tsaitepiao-alt/collar-frame/downloads/assembly.md

# 嘉蘭一號／二號 頸圈框：組裝與打樣

## 這是什麼

把「模組 + 織帶」串起來的**頸圈框**，機構分工寫死：

| 受力方向 | 誰負責 | 做法 |
|---|---|---|
| 側向／旋轉 | **機械擋（框壁）** | 6 mm 框壁把模組四面夾住，單邊 0.35 mm 餘隙 |
| 往下 | **機械擋（底部托台）** | 腔底留 2 mm 高托台，模組坐上去，重力也幫它 |
| 往外脫 | **磁吸（N35 Ø6×2 ×2）** | 只負責貼合與手感，不承力 |
| 前後 | **磁吸（扣件）** | 公母片對吸 |
| 拉力／剪力（扣件） | **機械擋（掛勾 + 擋牆）** | 勾子跨過母片上緣卡住，磁鐵不承力 |

**為什麼這樣分**：磁鐵一旦承力，貓甩頭幾次就會位移；反過來全部靠卡扣，單手又扣不上。所以磁鐵管「對位與手感」，擋塊管「受力」。

## 檔案

| 檔案 | 內容 |
|---|---|
| `src/lib/collar_params.py` | 全部尺寸的唯一來源（模組、磁鐵、織帶、扣件） |
| `src/lib/collar_shapes.py` | 框體／模組參考件／扣件幾何 |
| `src/frame_a.py` → `STEP/frame_a.step` | 嘉蘭一號框（68.5 × 44.5 × 11.5，零突出） |
| `src/frame_b.py` → `STEP/frame_b.step` | 嘉蘭二號框（56 × 44 × 17.8 模組） |
| `src/clasp_male.py` / `clasp_female.py` | 織帶扣件公／母 |
| `tmp/check_parts.py` | 幾何驗證（布林量體） |
| `PNG/` | 出圖 |

## 尺寸（來源）

- 嘉蘭一號 63 × 39 × 15、R7（`collar-base-system.html` VD.a）
- 嘉蘭二號 56 × 44 × 17.8、R7（VD.b）
- 織帶 20 × 2.5 mm（同頁零件表）
- 框外：一號 68.5 × 44.5、二號 61.5 × 49.5（= 模組 + 2×0.35 間隙 + 2×2.4 壁）

## 組裝順序

1. **埋磁鐵**（列印後）：把 Ø6×2 N35 放進背面的兩個窩（窩深 2.6，磁鐵 2.0 → 剩 0.6 給蓋片）。
2. **封蓋片**：Ø6.15 × 0.6 的蓋片壓入，**超音波熔接或溶劑黏（永久）**。這一步是防貓誤食的關鍵，不可只用雙面膠。
3. **裝模組**：模組上緣先斜入，下緣落到**底部托台**上，上緣兩角被磁鐵吸住。
4. **穿織帶**：20 mm 織帶從**背板內的貫穿通道**（21 × 2.8）穿過去，左右各留需要的長度後回折縫死／上調節扣。**先穿織帶再裝模組**，順序反了會卡住。
5. **接扣**：公片掛勾跨過母片上緣 → 勾子落進凹槽、碰到底部擋牆；兩片磁鐵對吸。
6. **拆**：掀上緣（磁力即可克服），或單手把扣件往反方向推開。

## 打樣

- **SLS PA12**（首選）：韌性好，卡扣與框耳不會斷；公差 ±0.3 mm，本設計最小餘隙 0.2 mm 仍在安全區。
- **FDM**：框耳與擋牆附近建議 4 圈牆；織帶孔上下的 1.5 mm 橫樑是最薄處，別低於 0.16 mm 層高。
- 量產（ABS/PC 射出）要重畫脫模斜度；磁鐵走**嵌件射出（insert molding）**，不要事後黏。

## 紅線檢查（貓用產品）

- [x] **磁鐵全包**：窩開在背面、前方 0.8 mm 塑膠、後方 0.6 mm 蓋片 → 咬不到
- [x] **無可拆小件**：磁鐵、蓋片都是永久固定；沒有可拆下的裝飾件
- [x] **安全脫開**：磁吸力就是防勾脫設計——貓勾到東西時會脫開，而不是勒住
- [ ] **拉力實測未做**：磁吸力要用彈簧秤量（目標 8–15 N 脫開、>4 N 不掉）

## 未驗證（照實說）

- 磁鐵吸力、脫開力**沒實測**，也沒做貓咪實戴。
- 模組背面要有對應的**鐵片或磁鐵**才吸得住——目前模組沒有這個件，要加 0.3 mm 鐵片貼片（這也是採購項）。
- 織帶通道藏在背板裡，所以背板加厚到 5.5 mm（外觀零突出，但整體厚度 +2.1）。
- 扣件的掛勾-擋牆咬合幾何上零干涉，但**插入力／拔出力未實測**。
