tsaitepiao-alt/collar-frame/downloads/frame_b.step

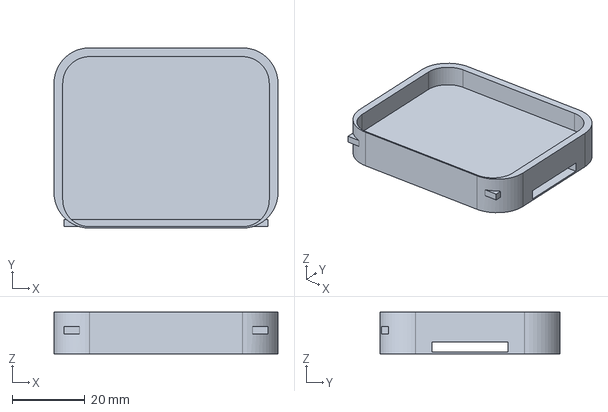
[picture p1: CAD file, 2026-11-03]
downloads/frame_b.step
61.5 x 49.5 x 11.5 mm
