tsaitepiao-alt/collar-frame/downloads/frame_a.step

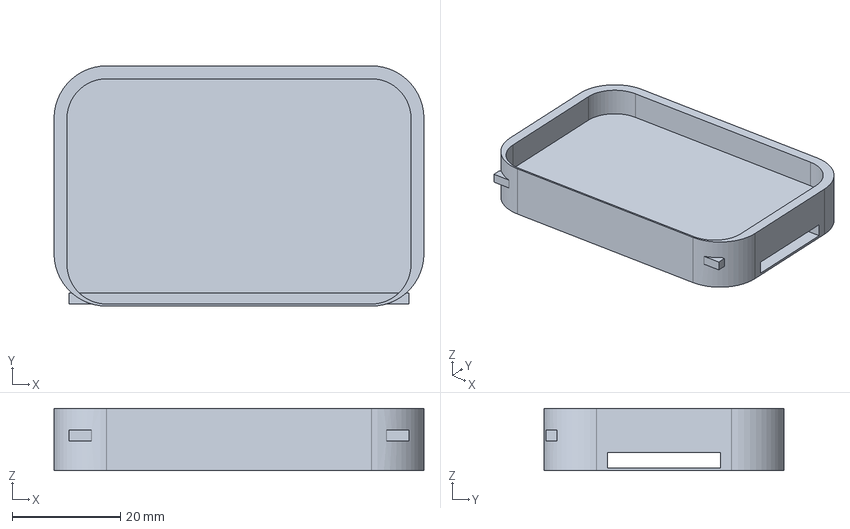
[picture p2: CAD file, 2026-11-03]
downloads/frame_a.step
68.5 x 44.5 x 11.5 mm
