tsaitepiao-alt/collar-frame/downloads/module_a.step

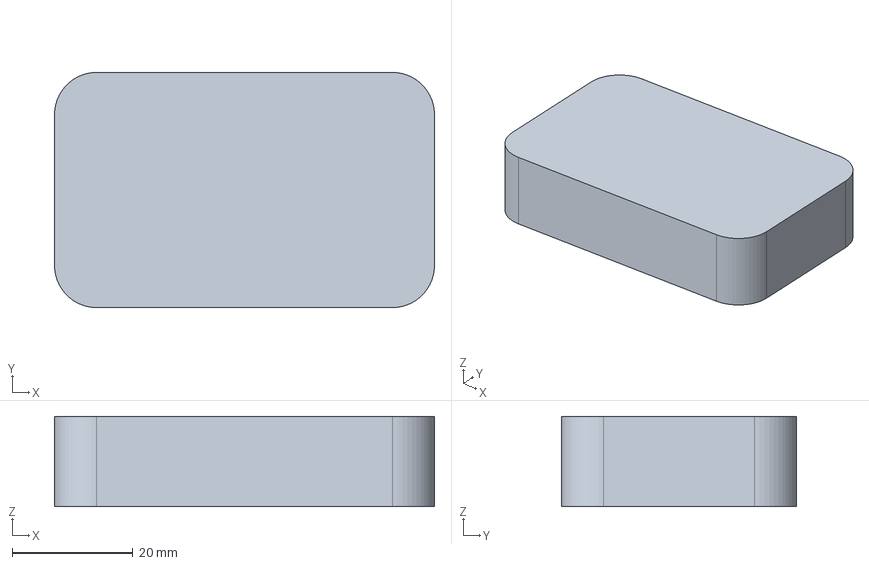
[picture p3: CAD file, 2026-11-03]
downloads/module_a.step
63.0 x 39.0 x 15.0 mm
