tsaitepiao-alt/collar-frame/downloads/clasp_female.step

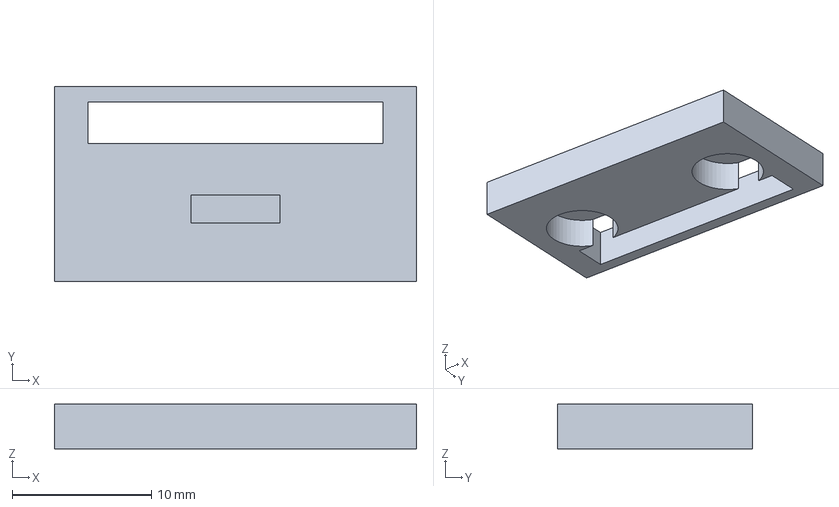
[picture p4: CAD file, 2026-11-03]
downloads/clasp_female.step
26.0 x 14.0 x 3.20 mm
