tsaitepiao-alt/collar-frame/downloads/clasp_male.step

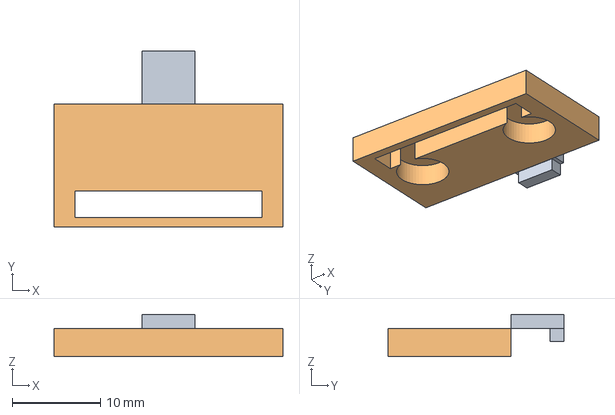
[picture p5: CAD file, 2026-11-03]
downloads/clasp_male.step
26.0 x 20.0 x 4.80 mm
