tsaitepiao-alt/collar-frame/(list of files, cad)

Other CAD files:
downloads/clasp_female.stl
downloads/clasp_male.stl
downloads/frame_a.stl
downloads/frame_b.stl
downloads/module_a.stl
