tsaitepiao-alt/collar-frame/(commit log)

2026-11-03 嘉蘭一號／二號 頸圈框：磁吸 + 機械擋塊（3D 檢視 + STEP/STL）
    [clasp_female.step, clasp_female.stl, clasp_male.step, clasp_male.stl, frame_a.step, frame_a.stl, frame_b.step, frame_b.stl]
2026-11-03 織帶改為背板內貫穿通道：外觀零突出（68.5×44.5×11.5）
    [frame_a.step, frame_a.stl, frame_b.step, frame_b.stl]
2026-11-03 頁面文案：織帶通道、零突出
2026-11-03 GLB 加版本參數，避免瀏覽器快取舊模型
